rcyaon/funbbit/README.md

# Funbbit

A modern recreation of the Sony PET-F7 "Funbbit" (1998): a virtual-pet
accessory for a Walkman (or any 3.5 mm player). It sits inline between the
player and the headphones, taps the audio without disturbing it, and animates
a pet on a 1.28" Sharp monochrome memory LCD. The pet dances while music plays
("dancing pet", "weight battle") and gets fat when it does not. An STM32U083
runs everything from a single **CR2032** coin cell.

## Renders

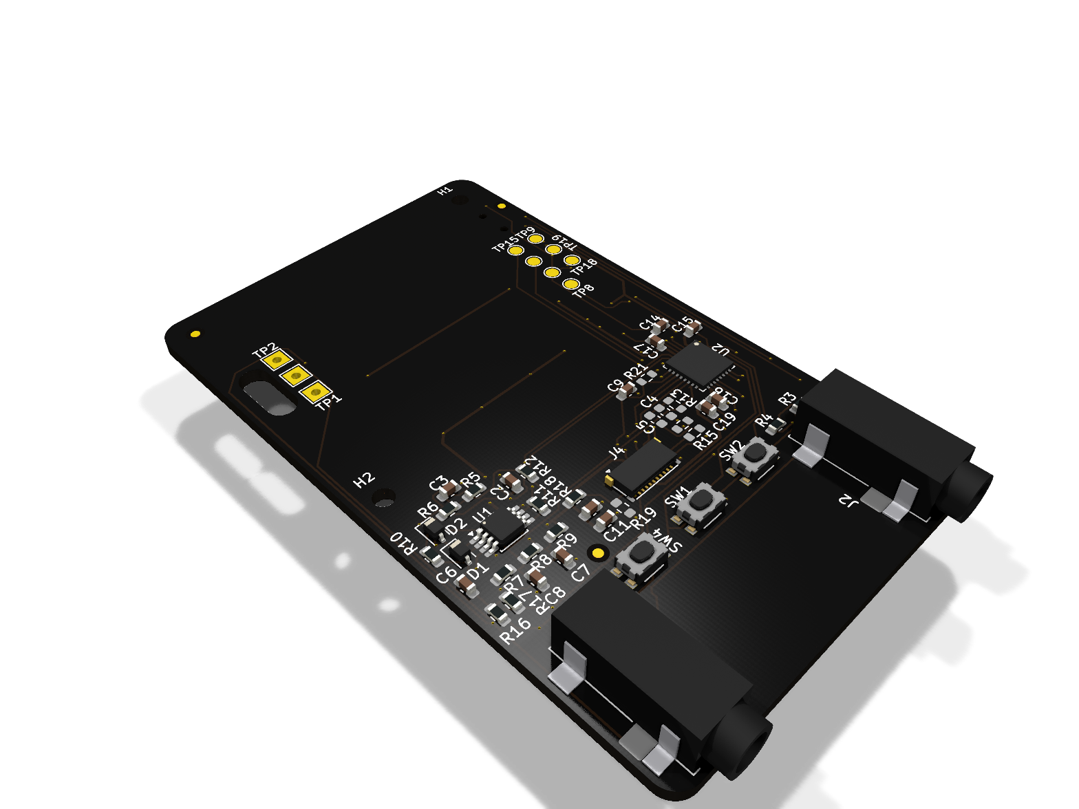
[picture p1: docs/renders/iso.png]
Funbbit PCB, isometric view


| Top | Bottom |
| --- | --- |
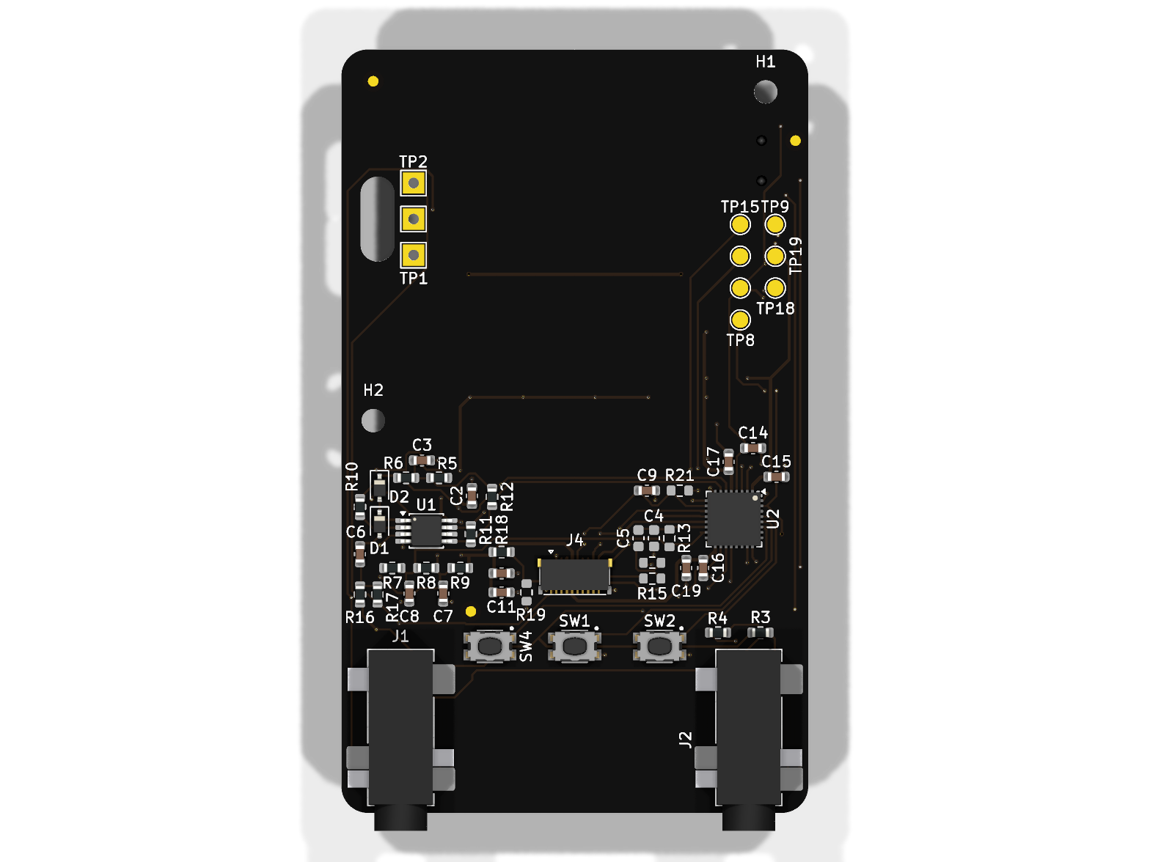
[picture p2: docs/renders/top.png]
Funbbit PCB, top side
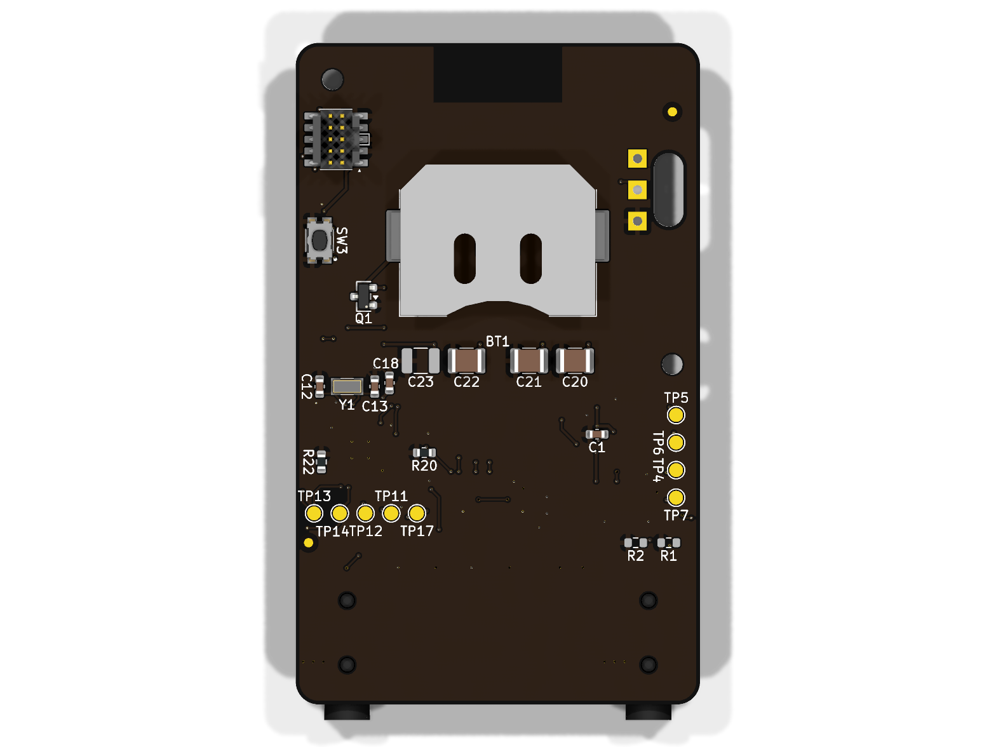
[picture p3: docs/renders/bottom.png]
Funbbit PCB, bottom side
|  |  |

44 x 72 mm, 2 layers, black mask, white silkscreen. The Sharp LCD (fitted by
hand into J4) and the CR2032 cell are not shown. 

## Pixel art

Pet sprites are drawn in [Aseprite](https://www.aseprite.org/).
