rcyaon/funbbit/fab/funbit-bom.csv

Designators | Qty | DNP | Manufacturer | MPN | Value/Description | Package | DigiKey PN | Mouser PN | LCSC PN | US unit price (USD) | US stock | Global stock | Match | Side | Instances | Notes
BT1 | 1 |  | Keystone Electronics | 3034TR | SMT retainer for one 20 mm coin cell (CR2032/CR2025/BR2016...), PCB pad is the negative contact |  | 36-3034TR-ND | 534-3034TR | C5199422 | 0.29584 | 86600 | 97 | MATCH_EXACT | bottom | POWER.BT_CELL
C1 C2 C9 C14 C15 C16 C17 | 7 |  | Murata Electronics | GRM188R72A104KA35D | 100nF X7R | 0603 | 490-3285-1-ND | 81-GRM188R72A104KA35 | C77058 | 0.16 | 301134 | 89348 | MATCH_COMPATIBLE | bottom/top | AUDIO_SENSE.C_AA, AUDIO_SENSE.C_AFE_VDD, DISPLAY.C_LCD_DISP, MCU.C_NRST, MCU.C_VDD1, MCU.C_VDD17, MCU.C_VDDA
C12 C13 | 2 |  | YAGEO | CC0603DRNPO9BN8R2 | 8.2pF C0G | 0603 | 311-1742-1-ND | 603-CC603DRNPO9BN8R2 | C3847265 | 0.1 | 40638 | 326 | MATCH_COMPATIBLE | bottom | MCU.C_LSE_IN, MCU.C_LSE_OUT
C19 | 1 |  | Murata Electronics | GRM188Z71C475KE21J | 4.7uF 6.3V X7R | 0603 | 490-GRM188Z71C475KE21JCT-ND | 581-KAM15CR70J475MT | C389010 | 0.29 | 10000 | 58368 | MATCH_COMPATIBLE | top | MCU.C_VDD_BULK
C20 C21 C22 | 3 |  | Murata Electronics | GRM32ER71A476KE15L | 47uF 10V X7R | 1210 | 490-5312-1-ND | 81-GRM32ER71A476KE5L | C84494 | 0.93 | 0 | 43824 | MATCH_EXACT | bottom | POWER.C_BULK1, POWER.C_BULK2, POWER.C_BULK3 | No US distributor stock at last check; LCSC stocks it (Diode extended part). Any 47 uF 10 V X7R 1210 MLCC is an acceptable substitute.
C3 | 1 |  | Murata Electronics | GRM188Z71E225ME43D | 2.2uF 25V X7R | 0603 | 490-GRM188Z71E225ME43DCT-ND | 81-GRM188Z71E225ME3D | C3856236 | 0.18 | 360903 | 4614 | MATCH_COMPATIBLE | top | AUDIO_SENSE.C_ENV
C6 | 1 |  | Murata Electronics | GCM188R71H224KA64D | 220nF X7R | 0603 | 490-5402-1-ND | 81-GCM188R71H224K64D | C97857 | 0.17 | 502732 | 55430 | MATCH_COMPATIBLE | top | AUDIO_SENSE.C_TAP_AC
C7 C8 C10 C11 C18 | 5 |  | Murata Electronics | GCM188R71E105KA64D | 1uF X7R | 0603 | 490-10673-1-ND | 81-GCM188R71E105KA4D | C85862 | 0.19 | 397758 | 111587 | MATCH_COMPATIBLE | bottom/top | AUDIO_SENSE.C_THRESH, AUDIO_SENSE.C_VMID, DISPLAY.C_LCD_VDD, DISPLAY.C_LCD_VDDA, MCU.C_VDDA_BULK
D1 D2 | 2 |  | Vishay | BAT54WS-HE3_A-08 | 200mA 30V Schottky Rectifier | SOD-323 | 112-BAT54WS-HE3_A-08CT-ND | 78-BAT54WS-HE3_A-08 | C324473 | 0.49 | 13200 | 38837 | MATCH_COMPATIBLE | top | AUDIO_SENSE.D_CLAMP, AUDIO_SENSE.D_OUT
J1 J2 | 2 |  | Same Sky | SJ-3523-SMT-TR | 3.5 mm stereo (TRS) audio jack, right angle, SMT, no switches |  | CP-3523SJCT-ND | 490-SJ-3523-SMT-TR |  | 0.88 | 80575 |  | MATCH_EXACT | top | AUDIO_PASSTHROUGH.J_AUDIO_IN, AUDIO_PASSTHROUGH.J_AUDIO_OUT
J3 | 1 |  | Samtec | FTSH-105-01-L-DV-K-A-P-TR | Samtec FTSH series 2x5 1.27 mm (0.050") pitch SMD pin header, 0.160" mating height, with alignme ... |  | SAM15419CT-ND | 200-FTSH1051FDVKAPTR | C21318670 | 2.27 | 3715 | 30 | MATCH_EXACT | bottom | DEBUG.J_SWD | Bottom side. Footprint v0.1.1: alignment holes 1.02 mm per Samtec layout Rev H.
J4 | 1 |  | Panasonic Industry | AYF531035 | 10-position 0.5 mm pitch FPC/FFC connector, top and bottom contacts, back lock, SMT, 1.0 mm high |  | 255-AYF531035CT-ND | 679-AYF531035A | C425133 | 0.88 | 9942 | 4886 | MATCH_EXACT | top | DISPLAY.J_LCD
Q1 | 1 |  | Diodes Incorporated | DMP2045U-7 | P-channel enhancement MOSFET, -20V, -4.3A, 45mOhm @ -4.5V, ESD-protected gate, SOT-23 |  | DMP2045U-7DICT-ND | 621-DMP2045U-7 | C459541 | 0.44 | 100676 | 14581 | MATCH_EXACT | bottom | POWER.Q_REVERSE
R10 | 1 |  | Panasonic Industry | ERJ-3EKF6202V | 62k | 0603 | P62.0KHCT-ND | 667-ERJ-3EKF6202V | C403306 | 0.1 | 51856 | 4871 | MATCH_COMPATIBLE | top | AUDIO_SENSE.R_FB
R11 | 1 |  | UNI-ROYAL(Uniroyal Elec) | 0603WAF2205T5E | 22M | 0603 |  | 303-0603WAF2205T5E | C3000522 | 0.006999999999999999 | 5000 | 402046 | MATCH_COMPATIBLE | top | AUDIO_SENSE.R_HYS_FB
R12 R16 R17 | 3 |  | Panasonic Industry | ERJ-3EKF1003V | 100k | 0603 | 13-RT0603FRE13100KLCT-ND | 667-ERJ-3EKF1003V | C189597 | 0.1 | 86198 | 747115 | MATCH_COMPATIBLE | top | AUDIO_SENSE.R_HYS_IN, AUDIO_SENSE.R_TAP_L, AUDIO_SENSE.R_TAP_R
R20 | 1 |  | Panasonic Industry | ERJ-3EKF1004V | 1M | 0603 | P1.00MHCT-ND | 667-ERJ-3EKF1004V | C193390 | 0.1 | 1369353 | 816 | MATCH_COMPATIBLE | bottom | DISPLAY.R_LCD_CS_PD
R22 | 1 |  | Panasonic Industry | ERJ-3EKF1002V | 10k | 0603 | P10.0KHCT-ND | 667-ERJ-3EKF1002V | C191124 | 0.1 | 2132308 | 435486 | MATCH_COMPATIBLE | bottom | MCU.R_BOOT0
R3 R4 R18 | 3 |  | Panasonic Industry | ERJ-3GEY0R00V | 0 | 0603 | P0.0GCT-ND | 667-ERJ-3GEY0R00V | C122704 | 0.1 | 4783703 | 262910 | MATCH_COMPATIBLE | top | AUDIO_PASSTHROUGH.R_LINK_L, AUDIO_PASSTHROUGH.R_LINK_R, DISPLAY.R_EXTMODE_HI | R18 (fitted) and R19 (DNP) are mutually exclusive LCD EXTMODE straps: never fit both (shorts VBAT to GND).
R5 | 1 |  | Panasonic Industry | ERJ-3EKF3302V | 33k | 0603 | P33.0KHCT-ND | 667-ERJ-3EKF3302V | C278619 | 0.1 | 145048 | 20009 | MATCH_COMPATIBLE | top | AUDIO_SENSE.R_AA
R6 | 1 |  | Panasonic Industry | ERJ-3EKF2701V | 2.7k | 0603 | P2.70KHCT-ND | 667-ERJ-3EKF2701V | C403121 | 0.11 | 92881 | 43480 | MATCH_COMPATIBLE | top | AUDIO_SENSE.R_ATT
R7 R9 | 2 |  | YAGEO | RC0603FR-132M2L | 2.2M | 0603 | 13-RC0603FR-132M2LCT-ND | 603-RC0603FR-132M2L | C22938 | 0.1 | 30051 | 227380 | MATCH_COMPATIBLE | top | AUDIO_SENSE.R_BIAS_BOT, AUDIO_SENSE.R_BIAS_TOP
R8 | 1 |  | Panasonic Industry | ERJ-3EKF3902V | 39k | 0603 | P39.0KHCT-ND | 667-ERJ-3EKF3902V | C278624 | 0.1 | 96376 | 19906 | MATCH_COMPATIBLE | top | AUDIO_SENSE.R_BIAS_MID
SW1 SW2 SW3 SW4 | 4 |  | C&K | KMR221NG LFS | Tactile switch SPST-NO, 2N, 32V 50mA, silver contacts, IP40, 4.2x2.8mm SMD gullwing |  | CKN10244CT-ND | 611-KMR221NGLFS | C269272 | 0.67 | 80743 | 7233 | MATCH_EXACT | bottom/top | HMI.SW_DANCE_A, HMI.SW_DANCE_B, HMI.SW_RESET, HMI.SW_SELECT
U1 | 1 |  | Microchip Technology | MCP6042T-I/MS | Dual 600nA/ch, 14kHz, 1.4-6.0V rail-to-rail I/O CMOS op amp, MSOP-8 |  | MCP6042T-I/MSCT-ND | 579-MCP6042T-I/MS | C627438 | 1.04 | 23176 | 461 | MATCH_EXACT | top | AUDIO_SENSE.U_AFE
U2 | 1 |  | STMicroelectronics | STM32U083KCU6 | STM32U083KC Arm Cortex-M0+ ultra-low-power MCU, 56 MHz, 256 KB flash, 40 KB SRAM, UFQFPN32 5x5 m ... |  | 497-STM32U083KCU6-ND | 511-STM32U083KCU6 | C22459164 | 3.8 | 13306 | 59 | MATCH_EXACT | top | MCU.U_MCU | DigiKey 497-STM32U083KCU6-ND currently 0 stock (364-day lead); buy from Mouser (13,306 in stock). STM32U073KCU6 is a pin-compatible no-AES alternate.
Y1 | 1 |  | Abracon LLC | ABS07-32.768KHZ-7-T | 32.768kHz 7pF | 3215_2Pin | 535-9543-1-ND | 815-ABS07-32.768K7T | C276424 | 0.86 | 401912 | 6373 | MATCH_EXACT | bottom | MCU.Y_LSE
C23 | 1 | DNP | Murata Electronics | GRM32ER71A476KE15L | 47uF 10V X7R | 1210 | 490-5312-1-ND | 81-GRM32ER71A476KE5L | C84494 | 0.93 | 0 | 43824 | MATCH_EXACT | DNP | POWER.C_BULK4 | No US distributor stock at last check; LCSC stocks it (Diode extended part). Any 47 uF 10 V X7R 1210 MLCC is an acceptable substitute.
C4 | 1 | DNP | Murata Electronics | GRM1885C1H152JA01D | 1.5nF C0G | 0603 | 490-1455-1-ND | 81-GRM1885C1H152JA01 | C880279 | 0.1 | 871349 | 11758 | MATCH_COMPATIBLE | DNP | AUDIO_SENSE.C_RAW_AA
C5 | 1 | DNP | Murata Electronics | GRM188R72A104KA35D | 100nF X7R | 0603 | 490-3285-1-ND | 81-GRM188R72A104KA35 | C77058 | 0.16 | 301134 | 89348 | MATCH_COMPATIBLE | DNP | AUDIO_SENSE.C_RAW_AC
R1 R2 | 2 | DNP | Panasonic Industry | ERJ-3EKF1002V | 10k | 0603 | P10.0KHCT-ND | 667-ERJ-3EKF1002V | C191124 | 0.1 | 2132308 | 435486 | MATCH_COMPATIBLE | DNP | AUDIO_PASSTHROUGH.R_BLEED_L, AUDIO_PASSTHROUGH.R_BLEED_R
R13 R14 R15 | 3 | DNP | Panasonic Industry | ERJ-3EKF1003V | 100k | 0603 | 13-RT0603FRE13100KLCT-ND | 667-ERJ-3EKF1003V | C189597 | 0.1 | 86198 | 747115 | MATCH_COMPATIBLE | DNP | AUDIO_SENSE.R_RAW_BIAS, AUDIO_SENSE.R_RAW_TAP_L, AUDIO_SENSE.R_RAW_TAP_R
R19 | 1 | DNP | Panasonic Industry | ERJ-3GEY0R00V | 0 | 0603 | P0.0GCT-ND | 667-ERJ-3GEY0R00V | C122704 | 0.1 | 4783703 | 262910 | MATCH_COMPATIBLE | DNP | DISPLAY.R_EXTMODE_LO | R18 (fitted) and R19 (DNP) are mutually exclusive LCD EXTMODE straps: never fit both (shorts VBAT to GND).
R21 | 1 | DNP | YAGEO | RC0603FR-0710ML | 10M | 0603 | 311-10.0MHRCT-ND | 603-RC0603FR-0710ML | C177620 | 0.1 | 47481 | 66968 | MATCH_COMPATIBLE | DNP | DISPLAY.R_LCD_DISP_PD
(hand-fit, not SMT) | 1 |  | Sharp | LS013B7DH03 | 1.28in 128x128 reflective memory LCD, plugs into J4 (AYF531035) | FPC module | 425-2903-ND |  |  | 12.39 |  |  | MATCH_EXACT | front (hand) | DISPLAY (off-board) | Not soldered: insert FPC into J4 after assembly, then fix the glass with thin tape.
