rcyaon/funbbit/fab/funbit-assembly-bottom.pdf

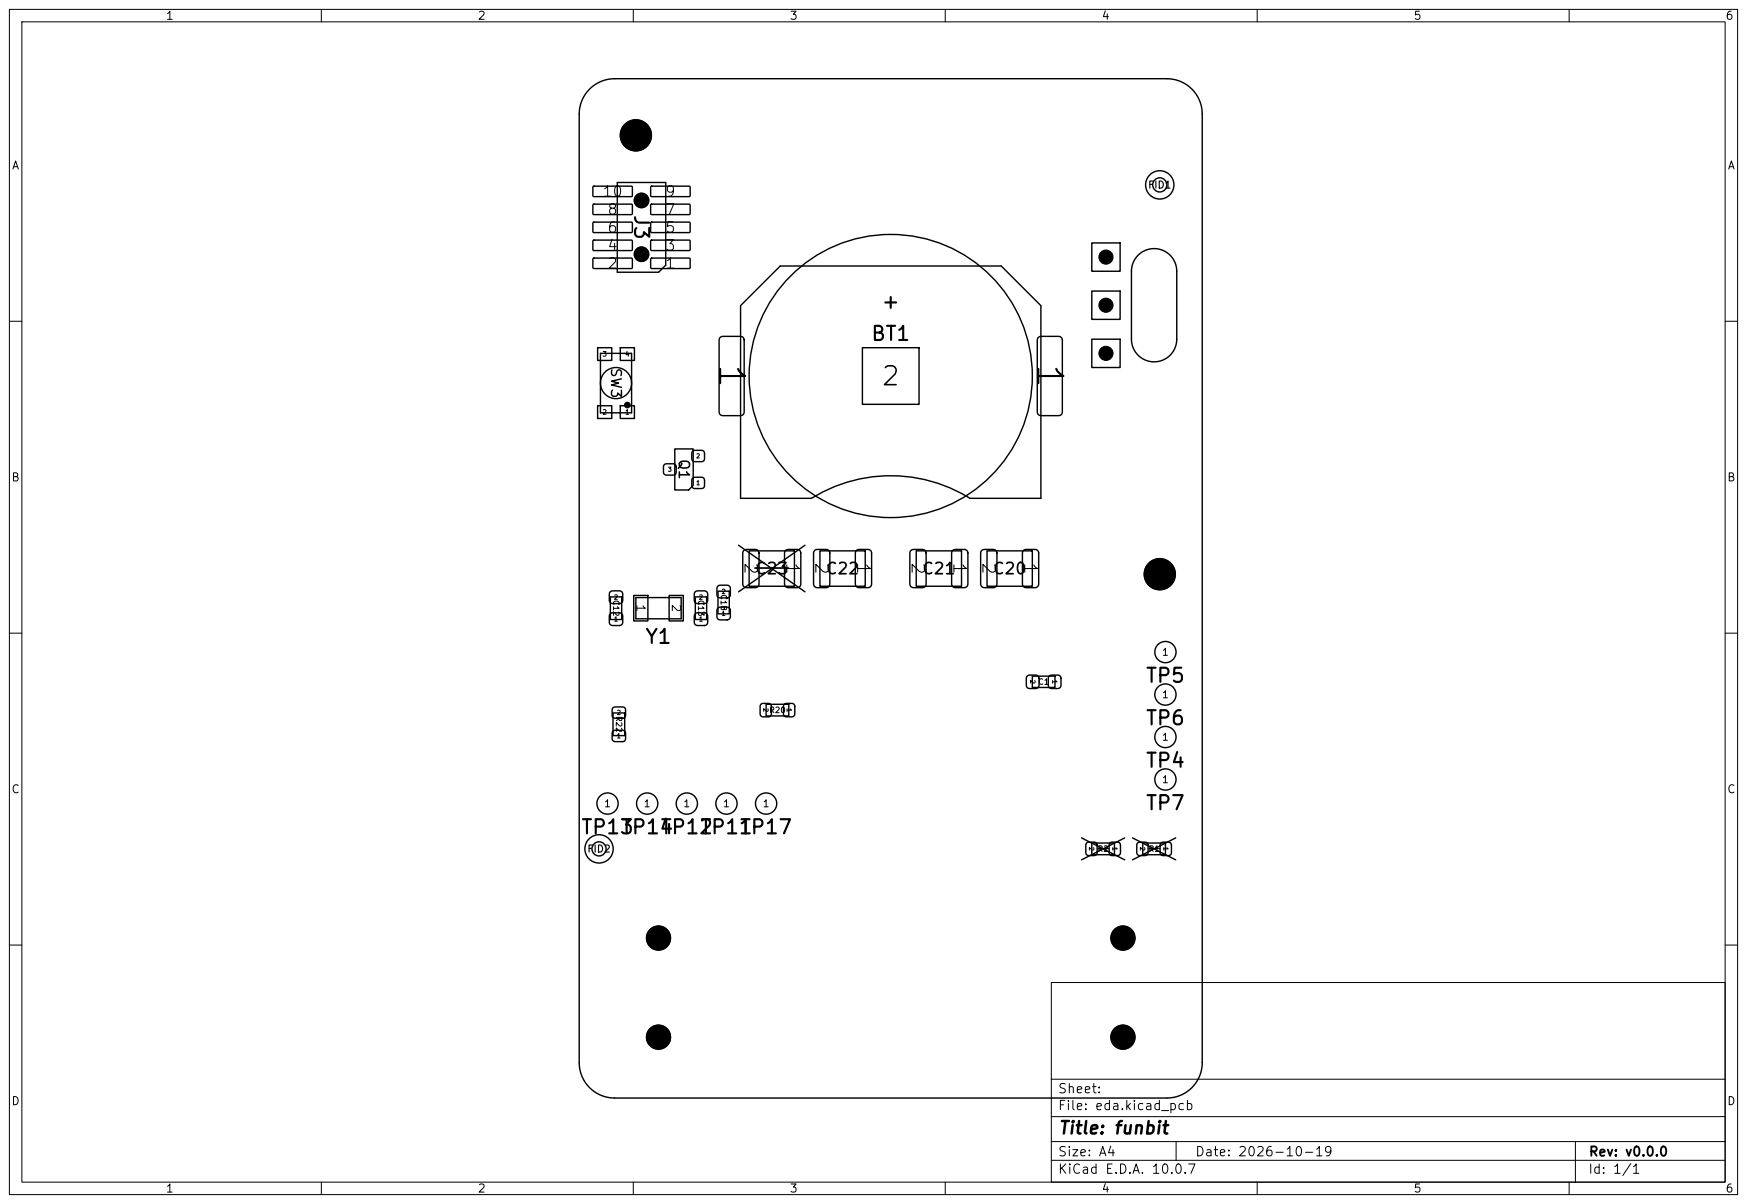
[picture p4: page 1]

Size: A4 | Rev: v0.0.0
KiCad E.D.A. 10.0.7 | Id: 1/1
