rcyaon/funbbit/fab/funbit-assembly-top.pdf

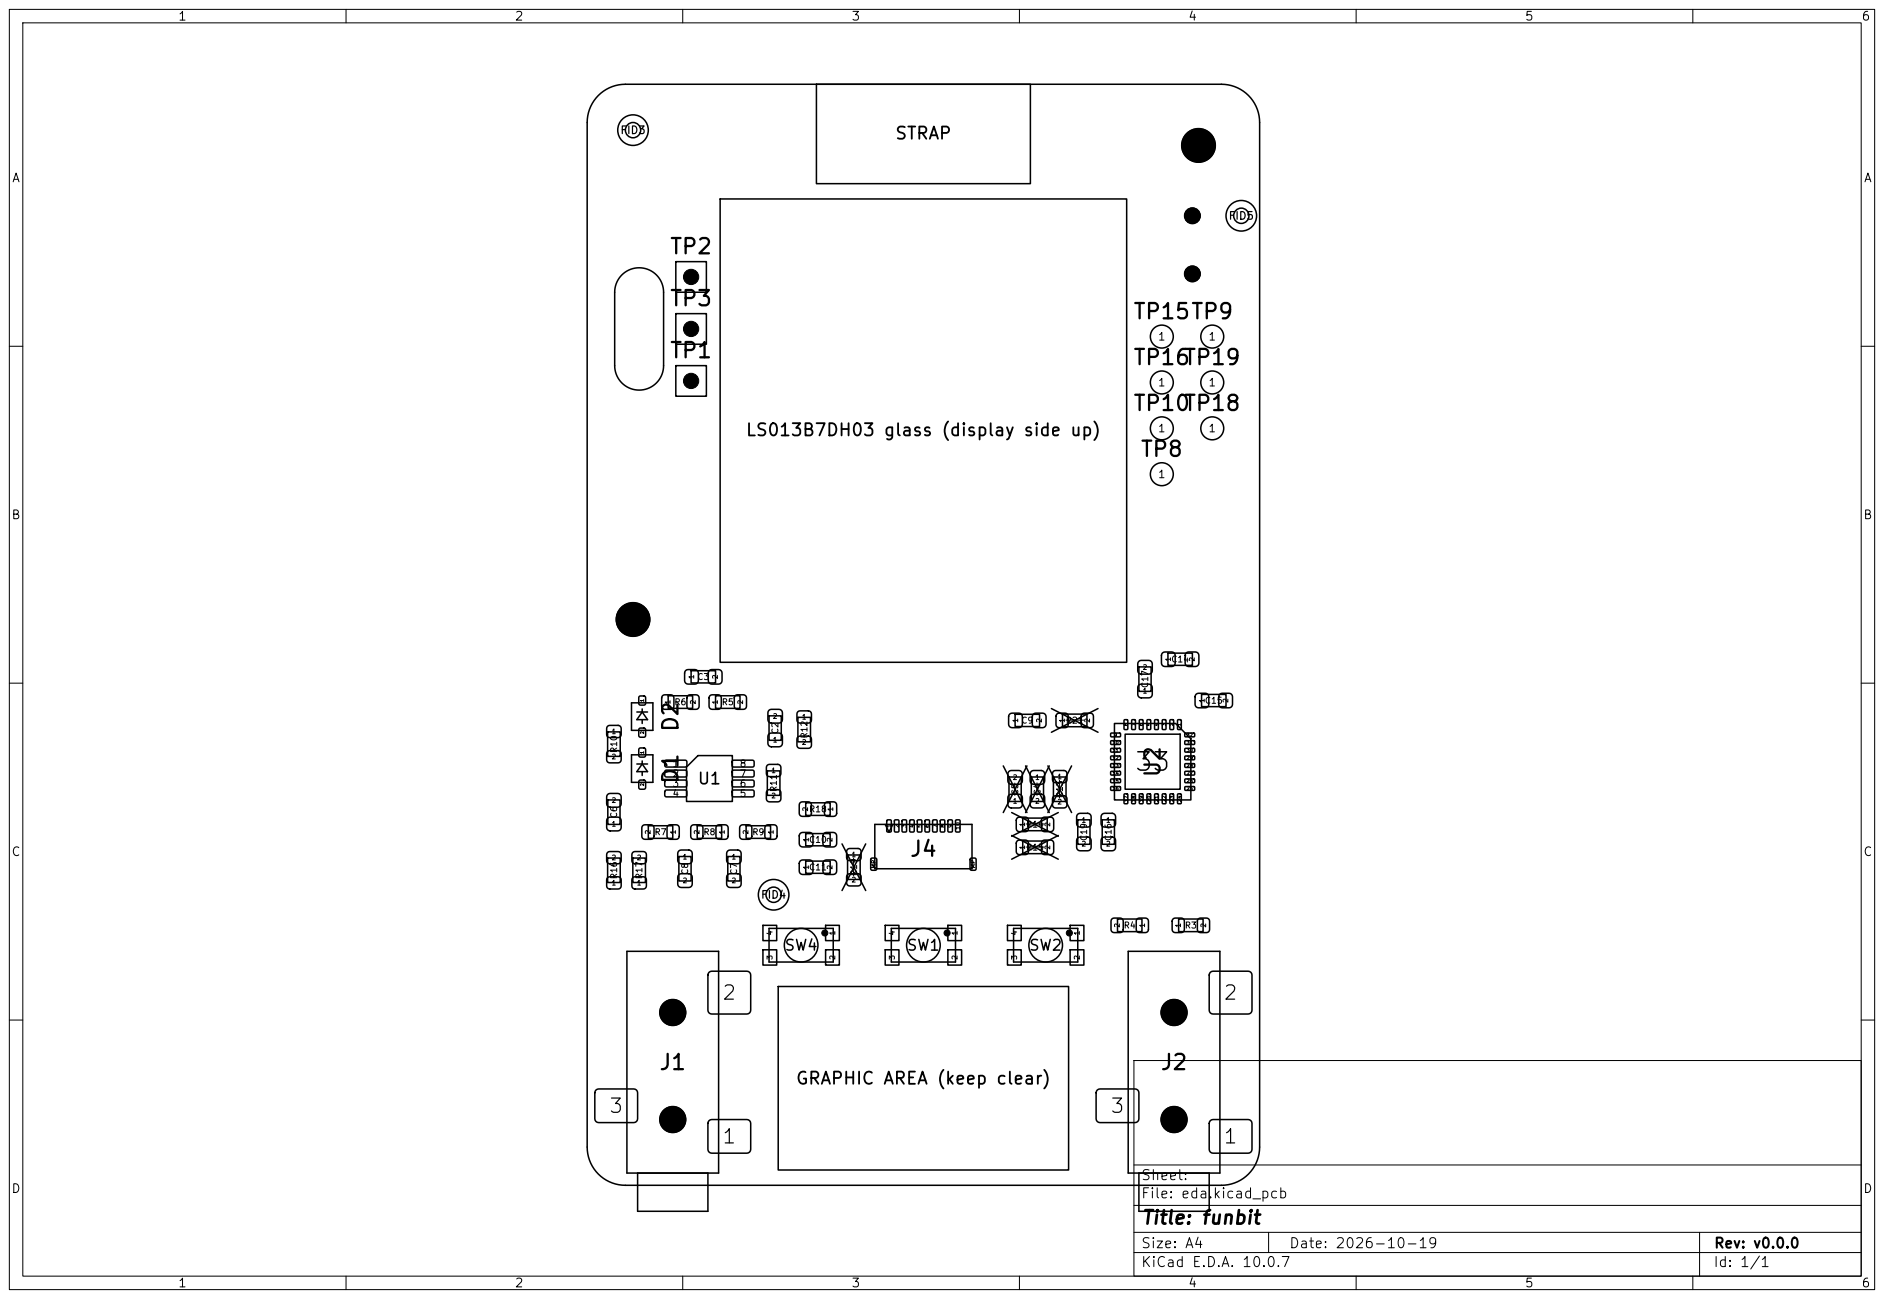
[picture p5: page 1]

LS013B7DH03 glass (display side up)

GRAPHIC AREA (keep clear)

Size: A4 | Rev: v0.0.0
KiCad E.D.A. 10.0.7 | Id: 1/1
