rcyaon/funbbit/fab/funbit-schematic.pdf

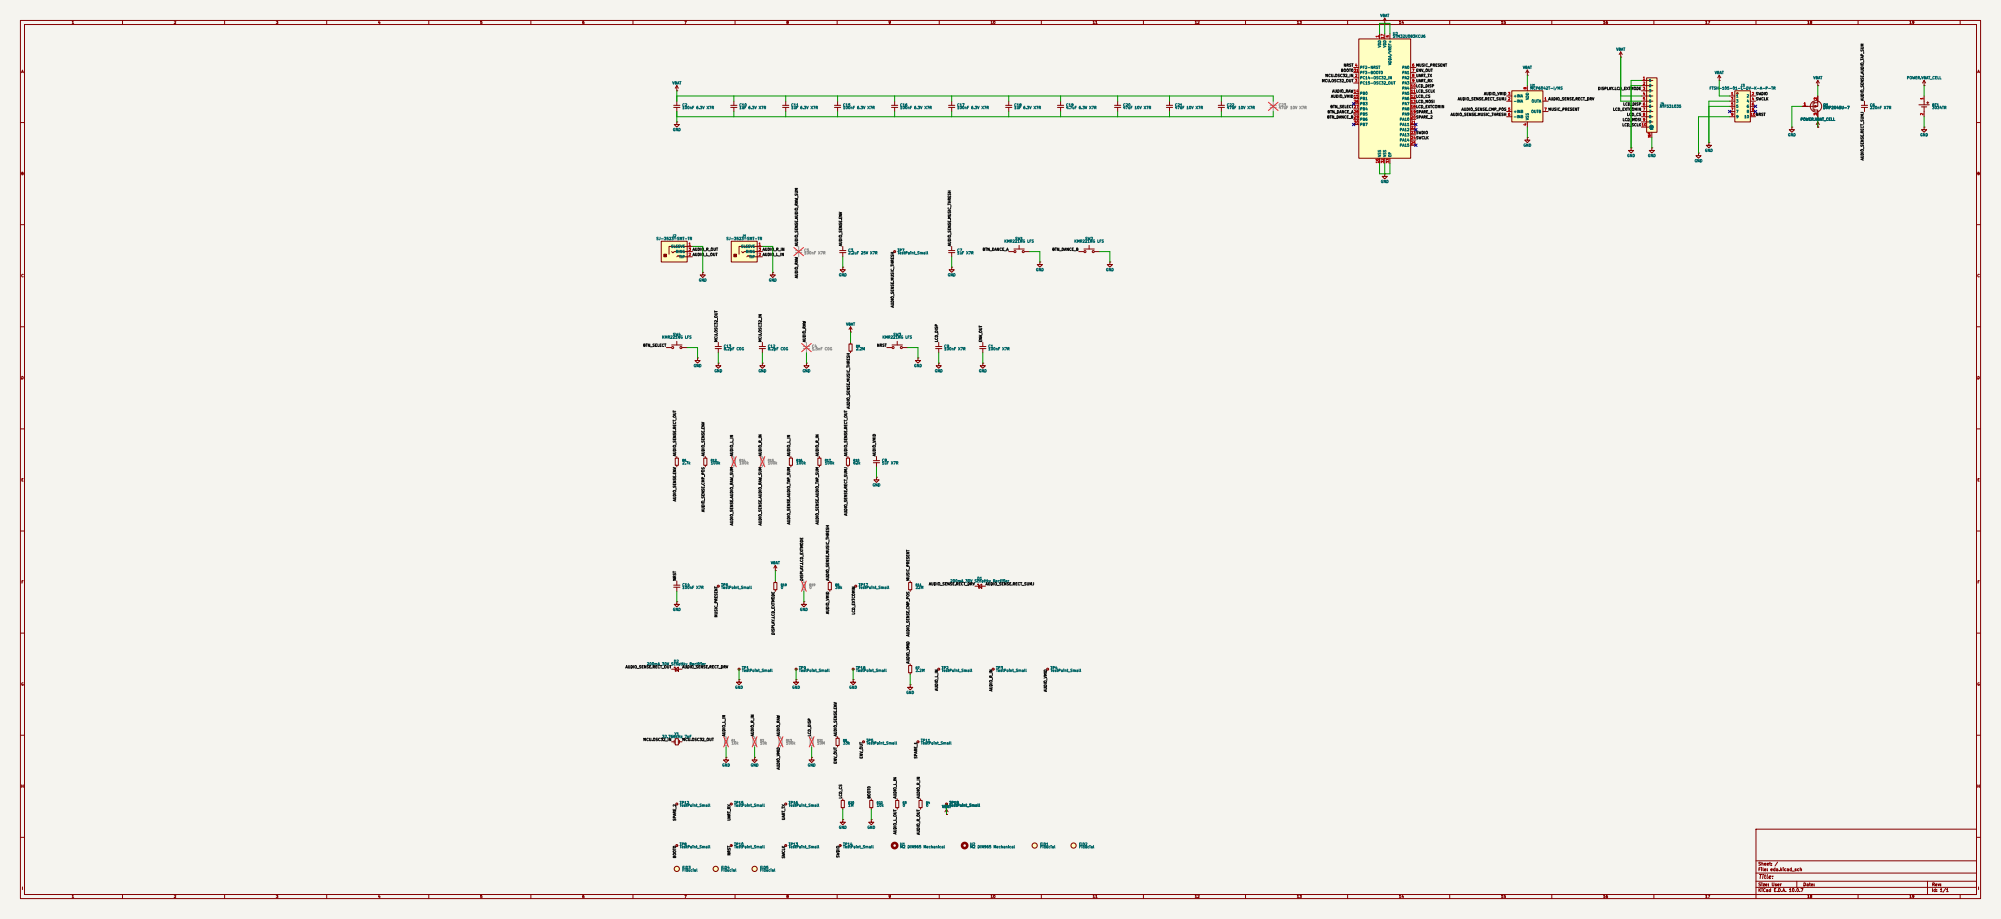
[picture p6: page 1]

Size: User | Rev:
KiCad E.D.A. 10.0.7 | Id: 1/1
