rcyaon/funbbit/fab/funbit-layers.pdf

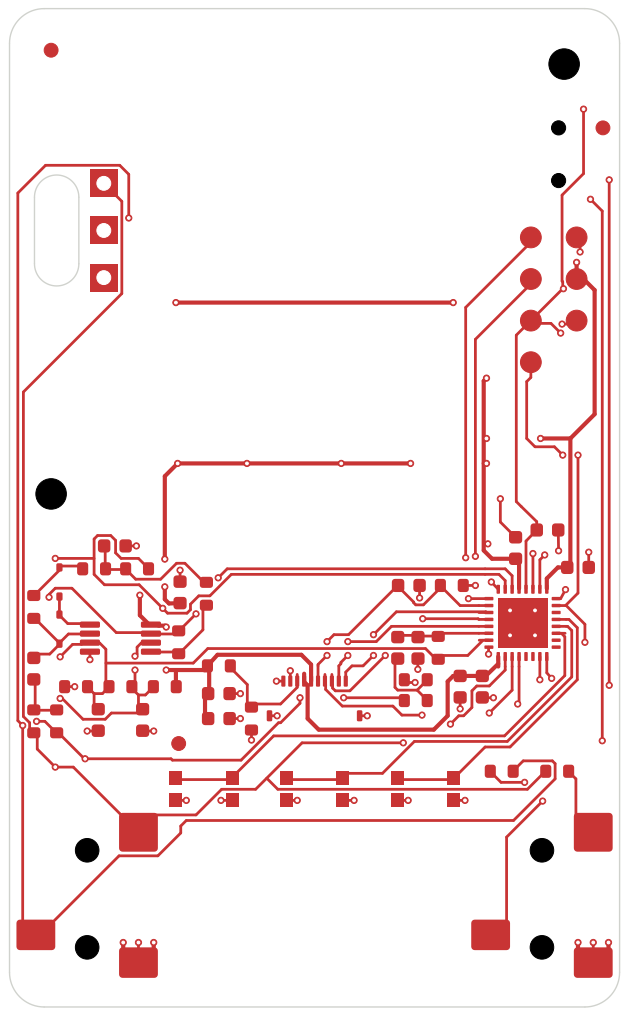
[picture p7: page 1]

Size: A4 | Rev: v0.0.0
KiCad E.D.A. 10.0.7 | Id: 1/6

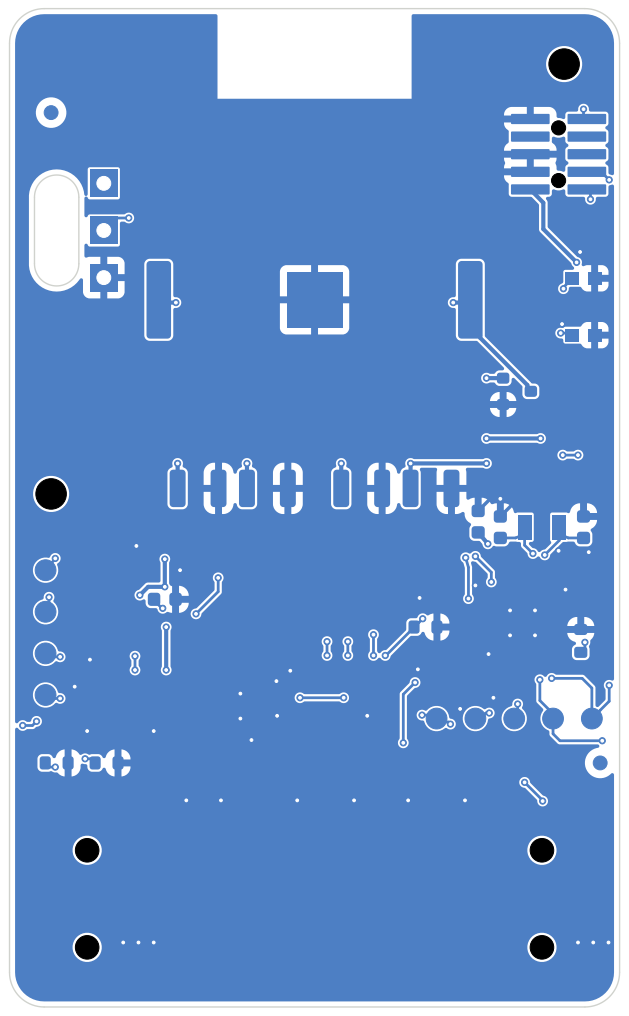
[picture p8: page 2]

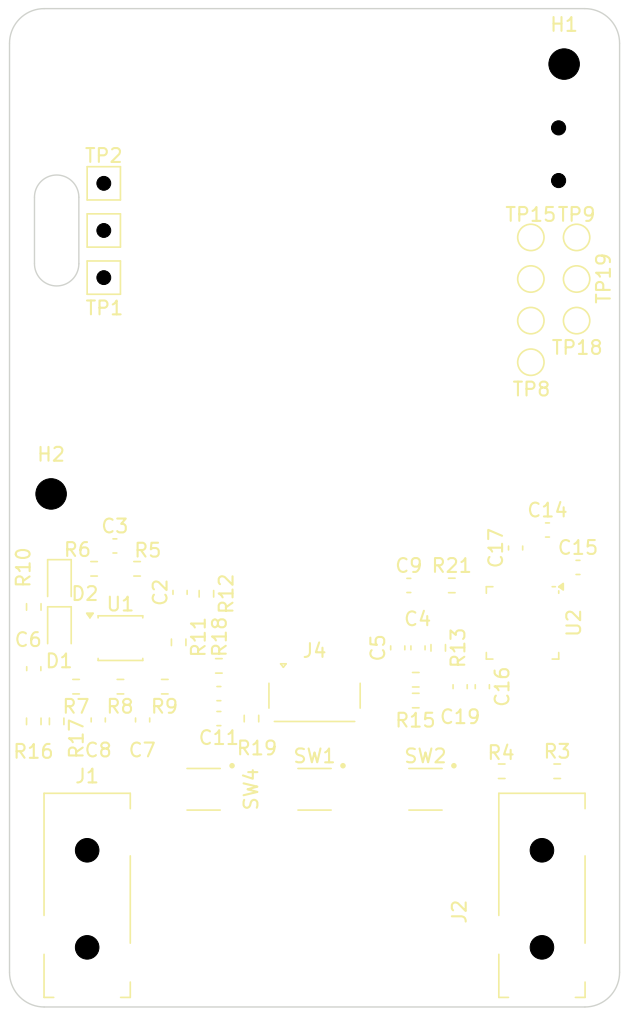
[picture p9: page 3]

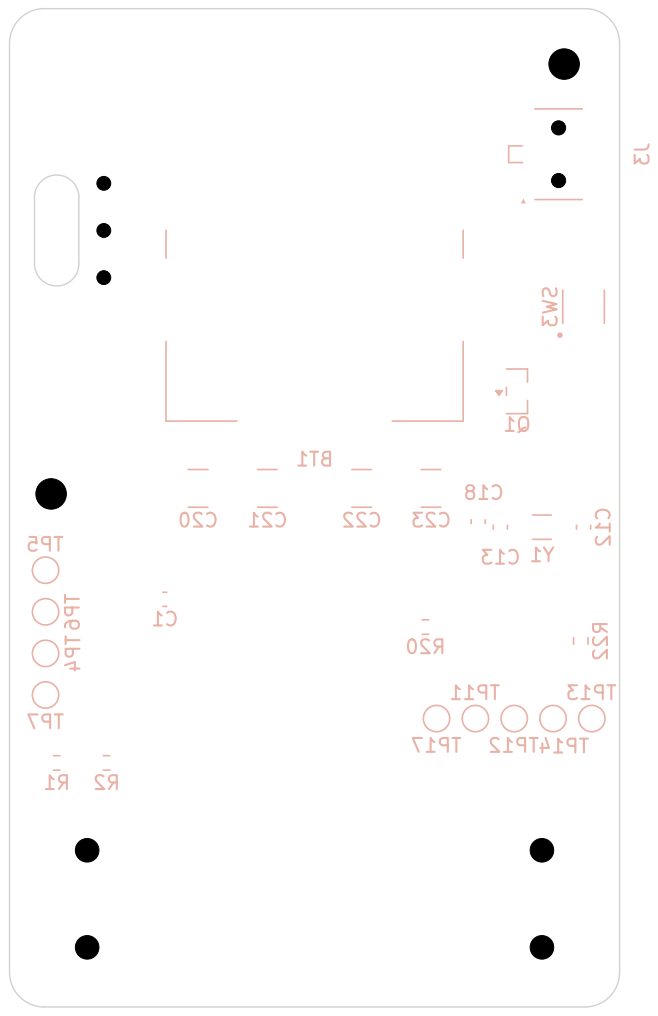
[picture p10: page 4]

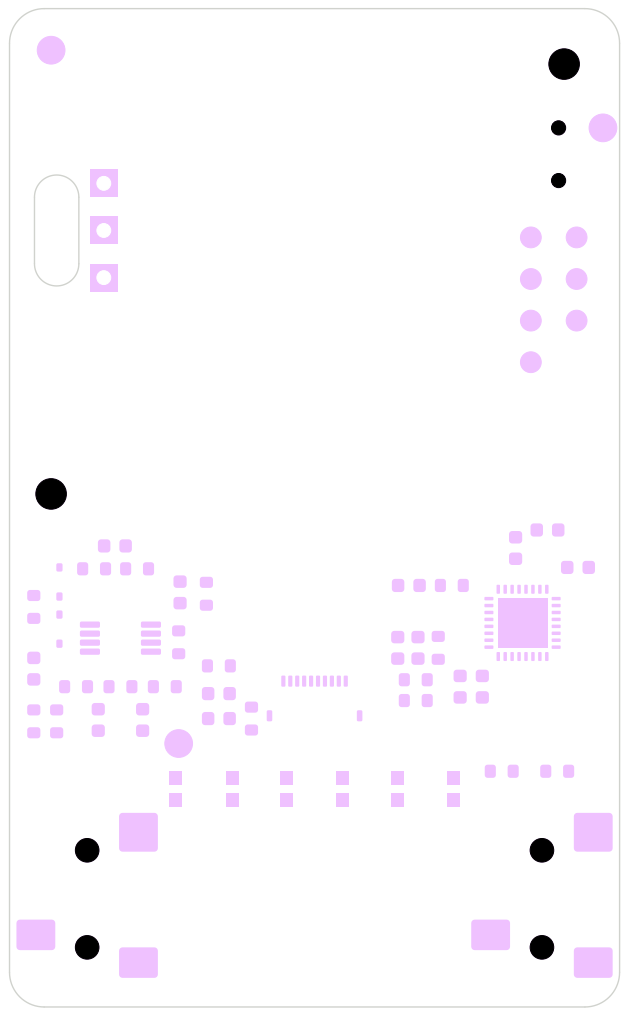
[picture p11: page 5]

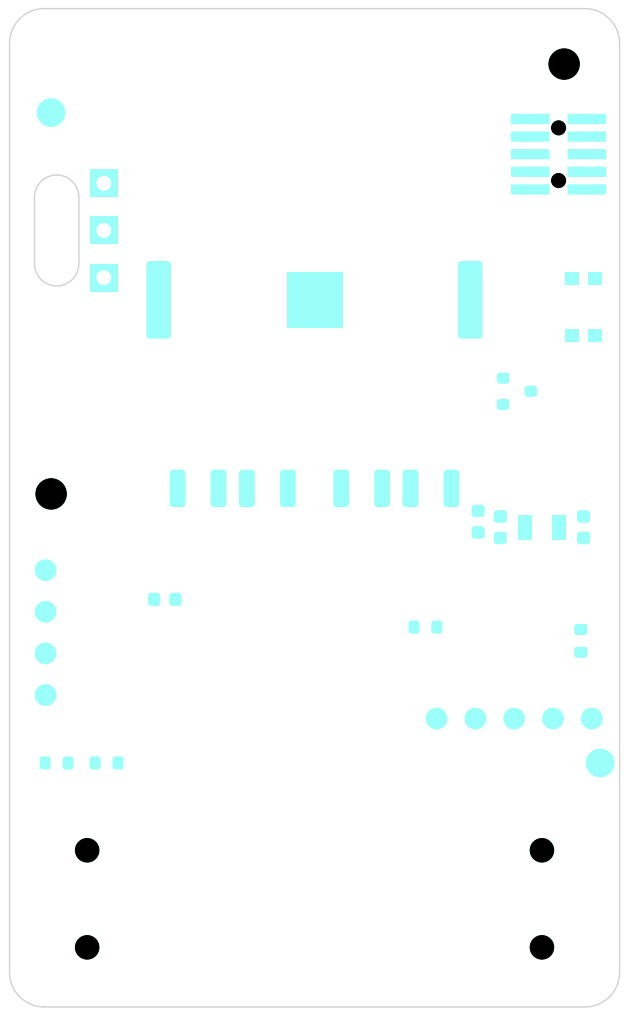
[picture p12: page 6]
