rcyaon/funbbit/eda/eda.kicad_pcb

## KiCad design eda/eda.kicad_pcb (2026-10-20)

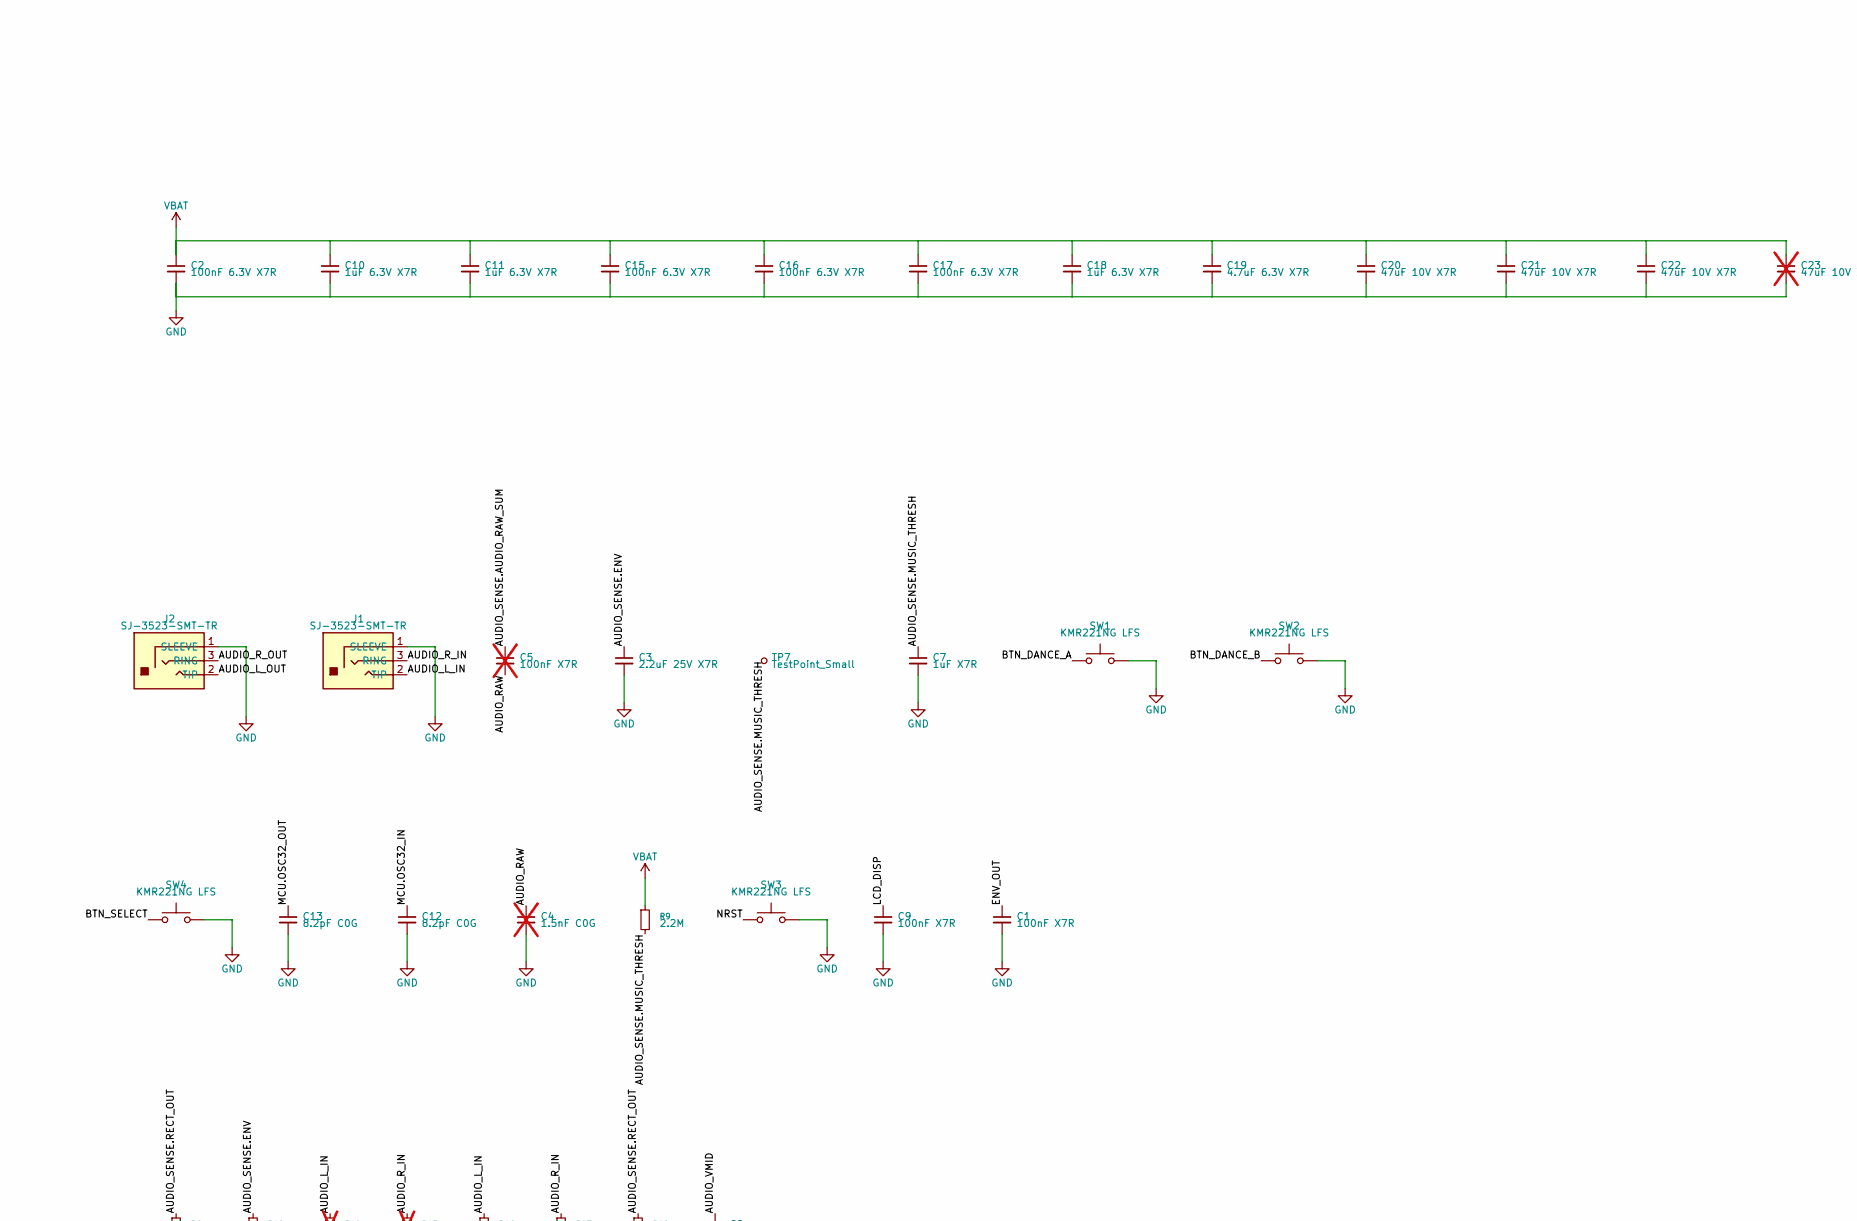
[picture p13: schematic eda.kicad_sch, part in row 1, column 1]

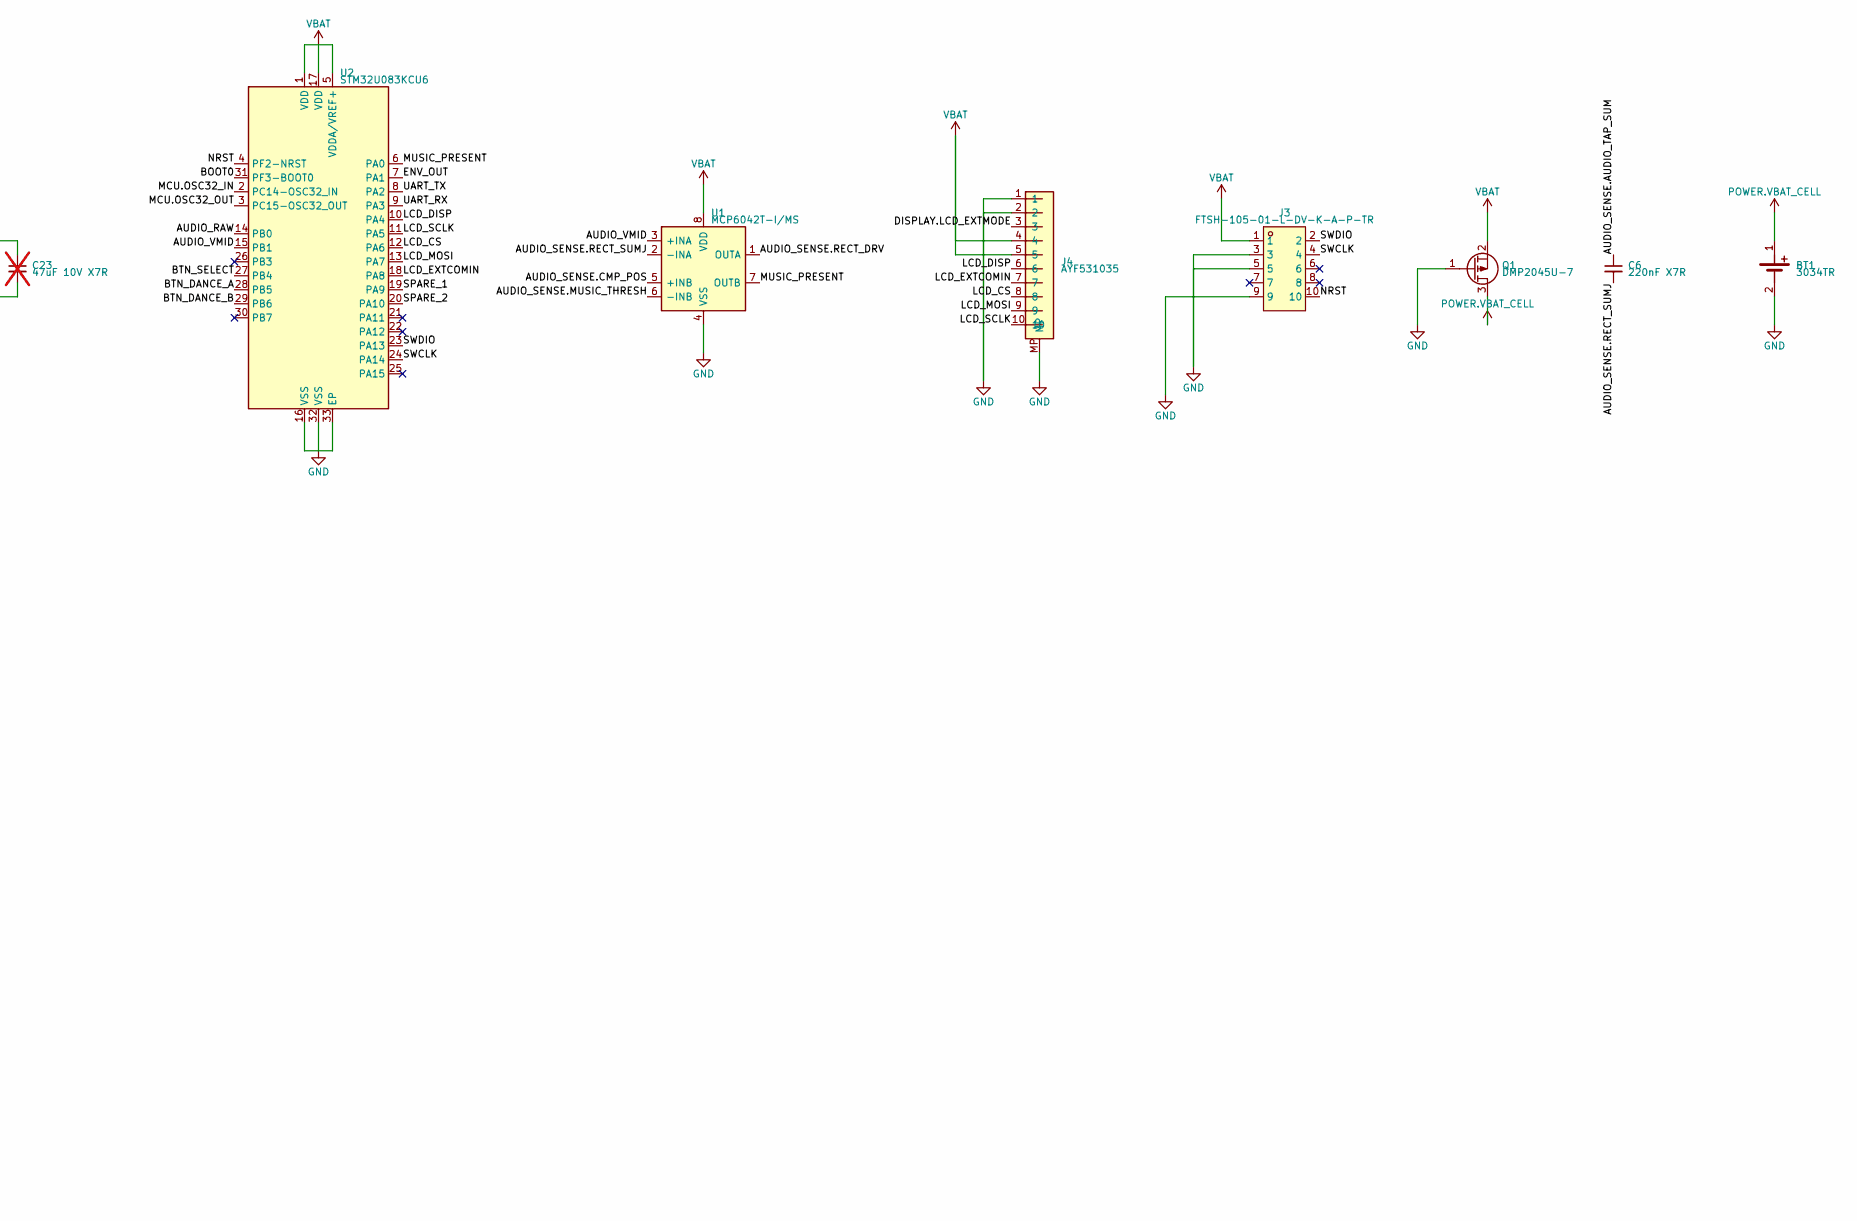
[picture p14: schematic eda.kicad_sch, part in row 1, column 2]

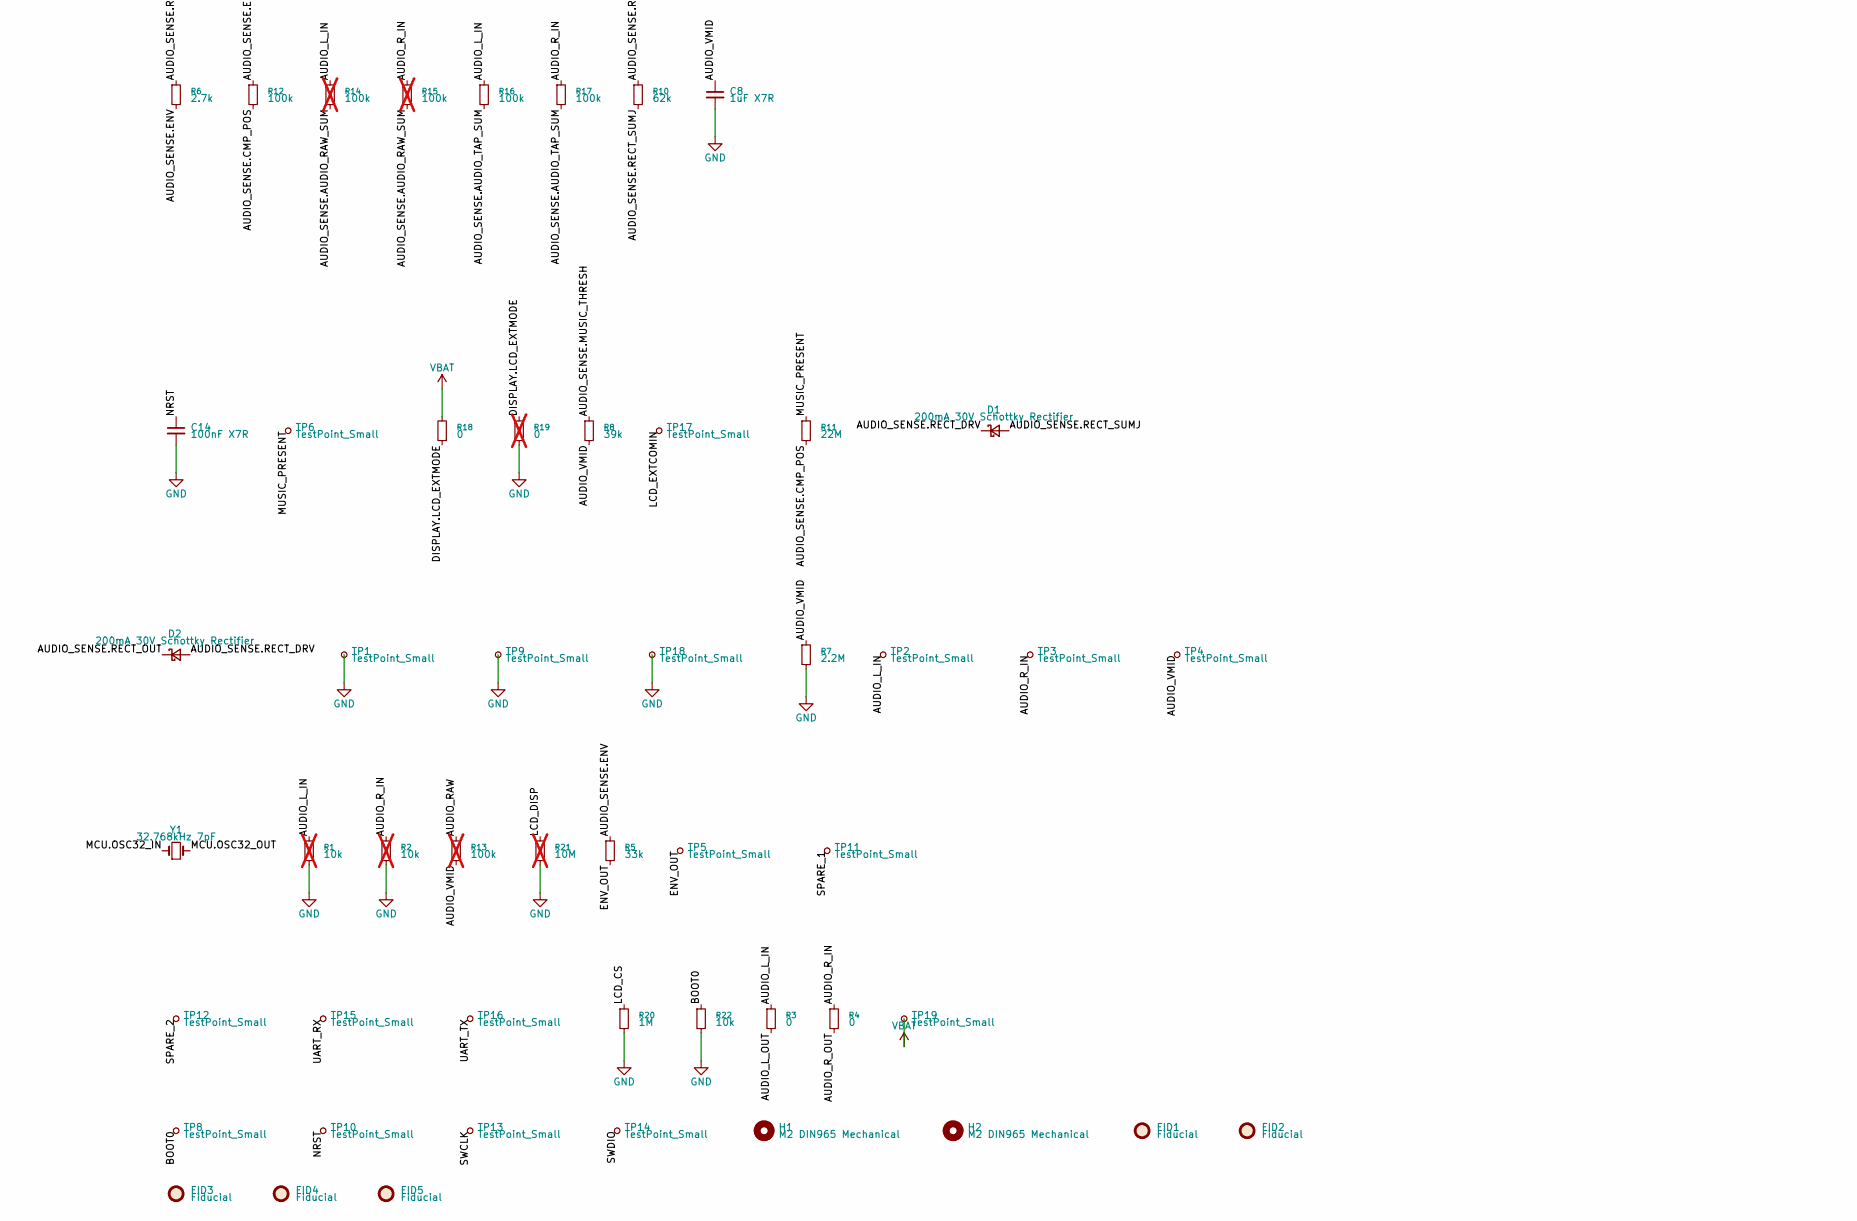
[picture p15: schematic eda.kicad_sch, part in row 2, column 1]

Parts:
BT1: 3034TR; Keystone_3034
C1, C9, C14: 100nF X7R; C_0603_1608Metric
C2, C15, C16, C17: 100nF 6.3V X7R; C_0603_1608Metric
C3: 2.2uF 25V X7R; C_0603_1608Metric
C4: 1.5nF C0G; C_0603_1608Metric; not fitted
C5: 100nF X7R; C_0603_1608Metric; not fitted
C6: 220nF X7R; C_0603_1608Metric
C7, C8: 1uF X7R; C_0603_1608Metric
C10, C11, C18: 1uF 6.3V X7R; C_0603_1608Metric
C12, C13: 8.2pF C0G; C_0603_1608Metric
C19: 4.7uF 6.3V X7R; C_0603_1608Metric
C20, C21, C22: 47uF 10V X7R; C_1210_3225Metric
C23: 47uF 10V X7R; C_1210_3225Metric; not fitted
D1, D2: 200mA 30V Schottky Rectifier; D_SOD-323
FID1, FID2, FID3, FID4, FID5: Fiducial; Fiducial_1mm_Mask2mm
H1, H2: M2 DIN965 Mechanical; MountingHole_2.2mm_M2_DIN965
J1, J2: SJ-3523-SMT-TR; SJ-3523-SMT
J3: FTSH-105-01-L-DV-K-A-P-TR
J4: AYF531035
Q1: DMP2045U-7; SOT-23_Diodes_Standard
R1, R2: 10k; R_0603_1608Metric; not fitted
R3, R4, R18: 0; R_0603_1608Metric
R5: 33k; R_0603_1608Metric
R6: 2.7k; R_0603_1608Metric
R7, R9: 2.2M; R_0603_1608Metric
R8: 39k; R_0603_1608Metric
R10: 62k; R_0603_1608Metric
R11: 22M; R_0603_1608Metric
R12, R16, R17: 100k; R_0603_1608Metric
R13, R14, R15: 100k; R_0603_1608Metric; not fitted
R19: 0; R_0603_1608Metric; not fitted
R20: 1M; R_0603_1608Metric
R21: 10M; R_0603_1608Metric; not fitted
R22: 10k; R_0603_1608Metric
SW1, SW2, SW3, SW4: KMR221NG LFS; KMR2x1NGLFS
TP1, TP2, TP3: TestPoint_Small; TestPoint_THTPad_2.0x2.0mm_Drill1.0mm
TP4, TP5, TP6, TP7, TP8, TP9, TP10, TP11, TP12, TP13, TP14, TP15, TP16, TP17, TP18, TP19: TestPoint_Small; TestPoint_Pad_D1.5mm
U1: MCP6042T-I/MS; MSOP-8_3x3mm_P0.65mm_Microchip_MS
U2: STM32U083KCU6; ST_UFQFPN-32-1EP_5x5mm_P0.5mm_EP3.6x3.6mm
Y1: 32.768kHz 7pF; Crystal_SMD_3215-2Pin_3.2x1.5mm

Connections:
AUDIO_L_IN: J1.2 (TIP), R1.1, R3.1, R14.1, R16.1, TP2.1
AUDIO_L_OUT: J2.2 (TIP), R3.2
AUDIO_RAW: C4.1, C5.2, R13.1, U2.14 (PB0)
AUDIO_R_IN: J1.3 (RING), R2.1, R4.1, R15.1, R17.1, TP3.1
AUDIO_R_OUT: J2.3 (RING), R4.2
AUDIO_SENSE.AUDIO_RAW_SUM: C5.1, R14.2, R15.2
AUDIO_SENSE.AUDIO_TAP_SUM: C6.1, R16.2, R17.2
AUDIO_SENSE.CMP_POS: R11.2, R12.2, U1.5 (+INB)
AUDIO_SENSE.ENV: C3.1, R5.1, R6.2, R12.1
AUDIO_SENSE.MUSIC_THRESH: C7.1, R8.1, R9.2, TP7.1, U1.6 (-INB)
AUDIO_SENSE.RECT_DRV: D1.1 (K), D2.2 (A), U1.1 (OUTA)
AUDIO_SENSE.RECT_OUT: D2.1 (K), R6.1, R10.1
AUDIO_SENSE.RECT_SUMJ: C6.2, D1.2 (A), R10.2, U1.2 (-INA)
AUDIO_VMID: C8.1, R7.1, R8.2, R13.2, TP4.1, U1.3 (+INA), U2.15 (PB1)
BOOT0: R22.1, TP8.1, U2.31 (PF3-BOOT0)
BTN_DANCE_A: SW1.1, SW1.4 (1), U2.28 (PB5)
BTN_DANCE_B: SW2.1, SW2.4 (1), U2.29 (PB6)
BTN_SELECT: SW4.1, SW4.4 (1), U2.27 (PB4)
DEBUG.J_SWD.NC_J_6: J3.6
DEBUG.J_SWD.NC_J_7: J3.7
DEBUG.J_SWD.NC_J_8: J3.8
DISPLAY.LCD_EXTMODE: J4.3, R18.1, R19.1
ENV_OUT: C1.1, R5.2, TP5.1, U2.7 (PA1)
GND: BT1.2 (NEG), C1.2, C2.2, C3.2, C4.2, C7.2, C8.2, C9.2, C10.2, C11.2, C12.2, C13.2, C14.2, C15.2, C16.2, C17.2, C18.2, C19.2, C20.2, C21.2, C22.2, C23.2, J1.1 (SLEEVE), J2.1 (SLEEVE), J3.3, J3.5, J3.9, J4.1, J4.2, J4.MP, Q1.1 (G), R1.2, R2.2, R7.2, R19.2, R20.2, R21.2, R22.2, SW1.2, SW1.3 (2), SW2.2, SW2.3 (2), SW3.2, SW3.3 (2), SW4.2, SW4.3 (2), TP1.1, TP9.1, TP18.1, U1.4 (VSS), U2.16 (VSS), U2.32 (VSS), U2.33 (EP)
LCD_CS: J4.8, R20.1, U2.12 (PA6)
LCD_DISP: C9.1, J4.6, R21.1, U2.10 (PA4)
LCD_EXTCOMIN: J4.7, TP17.1, U2.18 (PA8)
LCD_MOSI: J4.9, U2.13 (PA7)
LCD_SCLK: J4.10, U2.11 (PA5)
MCU.OSC32_IN: C12.1, U2.2 (PC14-OSC32_IN), Y1.1
MCU.OSC32_OUT: C13.1, U2.3 (PC15-OSC32_OUT), Y1.2
MCU.U_MCU.NC_STM32U083KCU6_PA11: U2.21 (PA11)
MCU.U_MCU.NC_STM32U083KCU6_PA12: U2.22 (PA12)
MCU.U_MCU.NC_STM32U083KCU6_PA15: U2.25 (PA15)
MCU.U_MCU.NC_STM32U083KCU6_PB3: U2.26 (PB3)
MCU.U_MCU.NC_STM32U083KCU6_PB7: U2.30 (PB7)
MUSIC_PRESENT: R11.1, TP6.1, U1.7 (OUTB), U2.6 (PA0)
NRST: C14.1, J3.10, SW3.1, SW3.4 (1), TP10.1, U2.4 (PF2-NRST)
POWER.VBAT_CELL: BT1.1 (POS), Q1.3 (D)
SPARE_1: TP11.1, U2.19 (PA9)
SPARE_2: TP12.1, U2.20 (PA10)
SWCLK: J3.4, TP13.1, U2.24 (PA14)
SWDIO: J3.2, TP14.1, U2.23 (PA13)
UART_RX: TP15.1, U2.9 (PA3)
UART_TX: TP16.1, U2.8 (PA2)
VBAT: C2.1, C10.1, C11.1, C15.1, C16.1, C17.1, C18.1, C19.1, C20.1, C21.1, C22.1, C23.1, J3.1, J4.4, J4.5, Q1.2 (S), R9.1, R18.2, TP19.1, U1.8 (VDD), U2.1 (VDD), U2.5 (VDDA/VREF+), U2.17 (VDD)

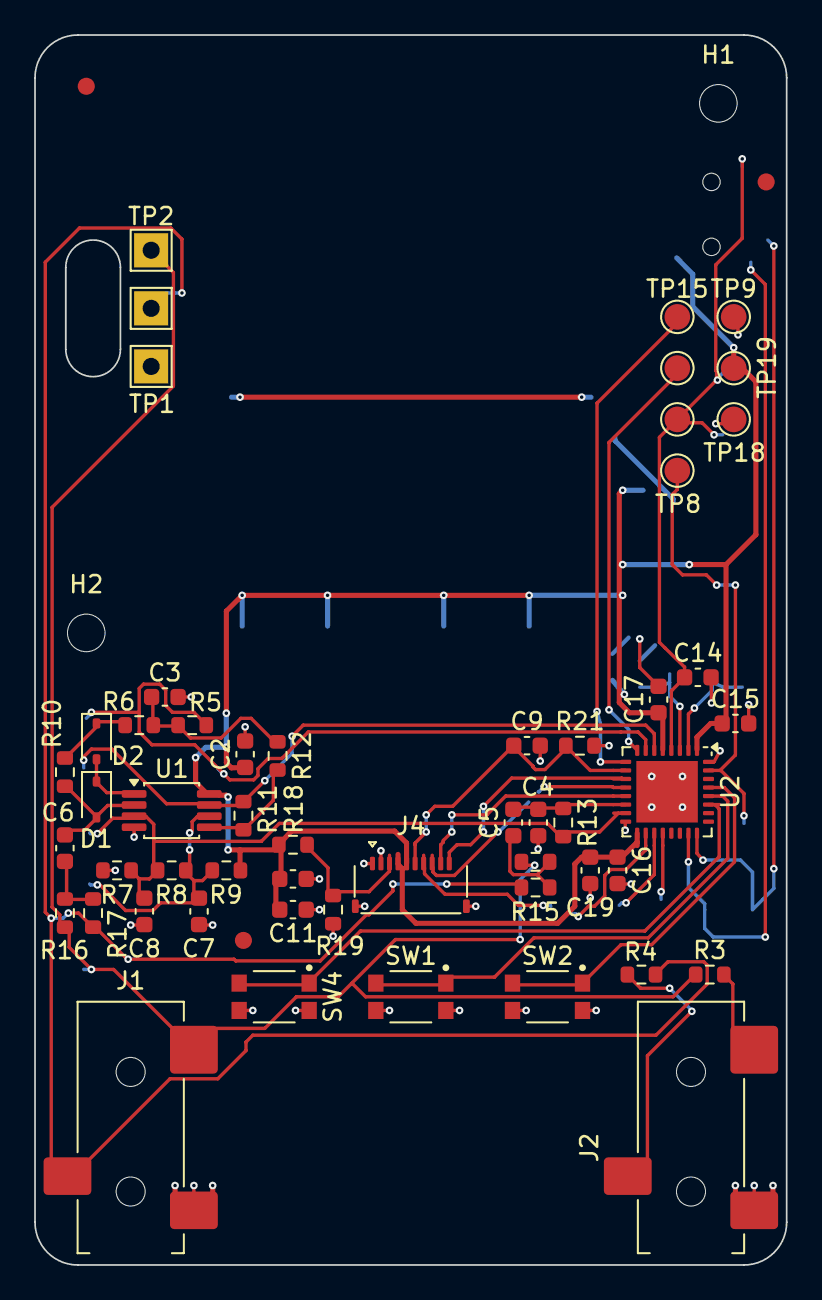
[picture p16: board eda.kicad_pcb from above]

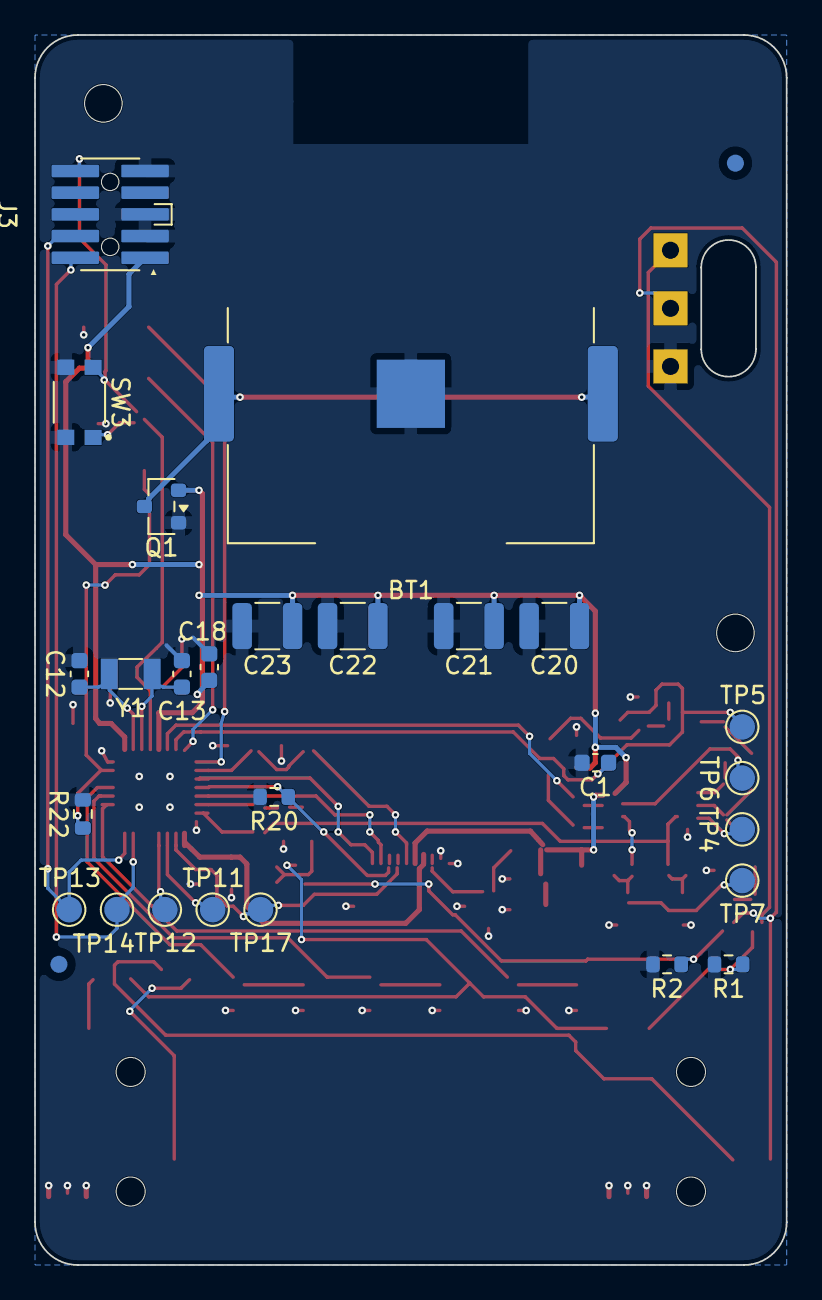
[picture p17: board eda.kicad_pcb from below]

Board: 2 copper layers, 44.0 x 72.0 mm, 86 parts (28 on the bottom side), 38 nets.
